chipfail/pmod-mux/README.md

# MUX PMOD Hardware
MUX PMOD Hardware

[Digikey Cart for 10 boards](https://www.digikey.com/short/pm0rpt)
