chipfail/pmod-mux/Rev A/Gerbers/read_me.txt

Cryptotronix LLC
Kirill V. Belyayev
kirill@cryptotronix.com
MUX PMOD PCB, Rev A
06/13/2019

Files included:
  muxpmod_2019-06-13.zip    A zip file of all PCB gerbers

PCB Fab Requirements:
  - 2-Layer PCB Stackup
  - 1oz Top and Bottom Copper Thickness
  - Finish: Lead Free HASL
  - Soldermask on top and bottom
  - Silkscreen on top and bottom
  - PCB Thickness: 0.062"
  - PCB Material: FR-04

Gerber File Naming Conventions
  copper_top.gbr                Top Copper
  solderpaste_top.gbr           Top Paste
  silkscreen_top.gbr            Top Silkscreen
  soldermask_top.gbr            Top Soldermask
  copper_bottom.gbr             Bottom Copper
  solderpaste_bottom.gbr        Bottom Paste
  silkscreen_bottom.gbr         Bottom Silkscreen
  soldermask_bottom.gbr         Bottom Soldermask
  profile.gbr                   PCB Outline
  drills.xln                    Drill File, Excellon 24 format
