chipfail/pmod-mux/Rev A/muxpmod-schematics.pdf

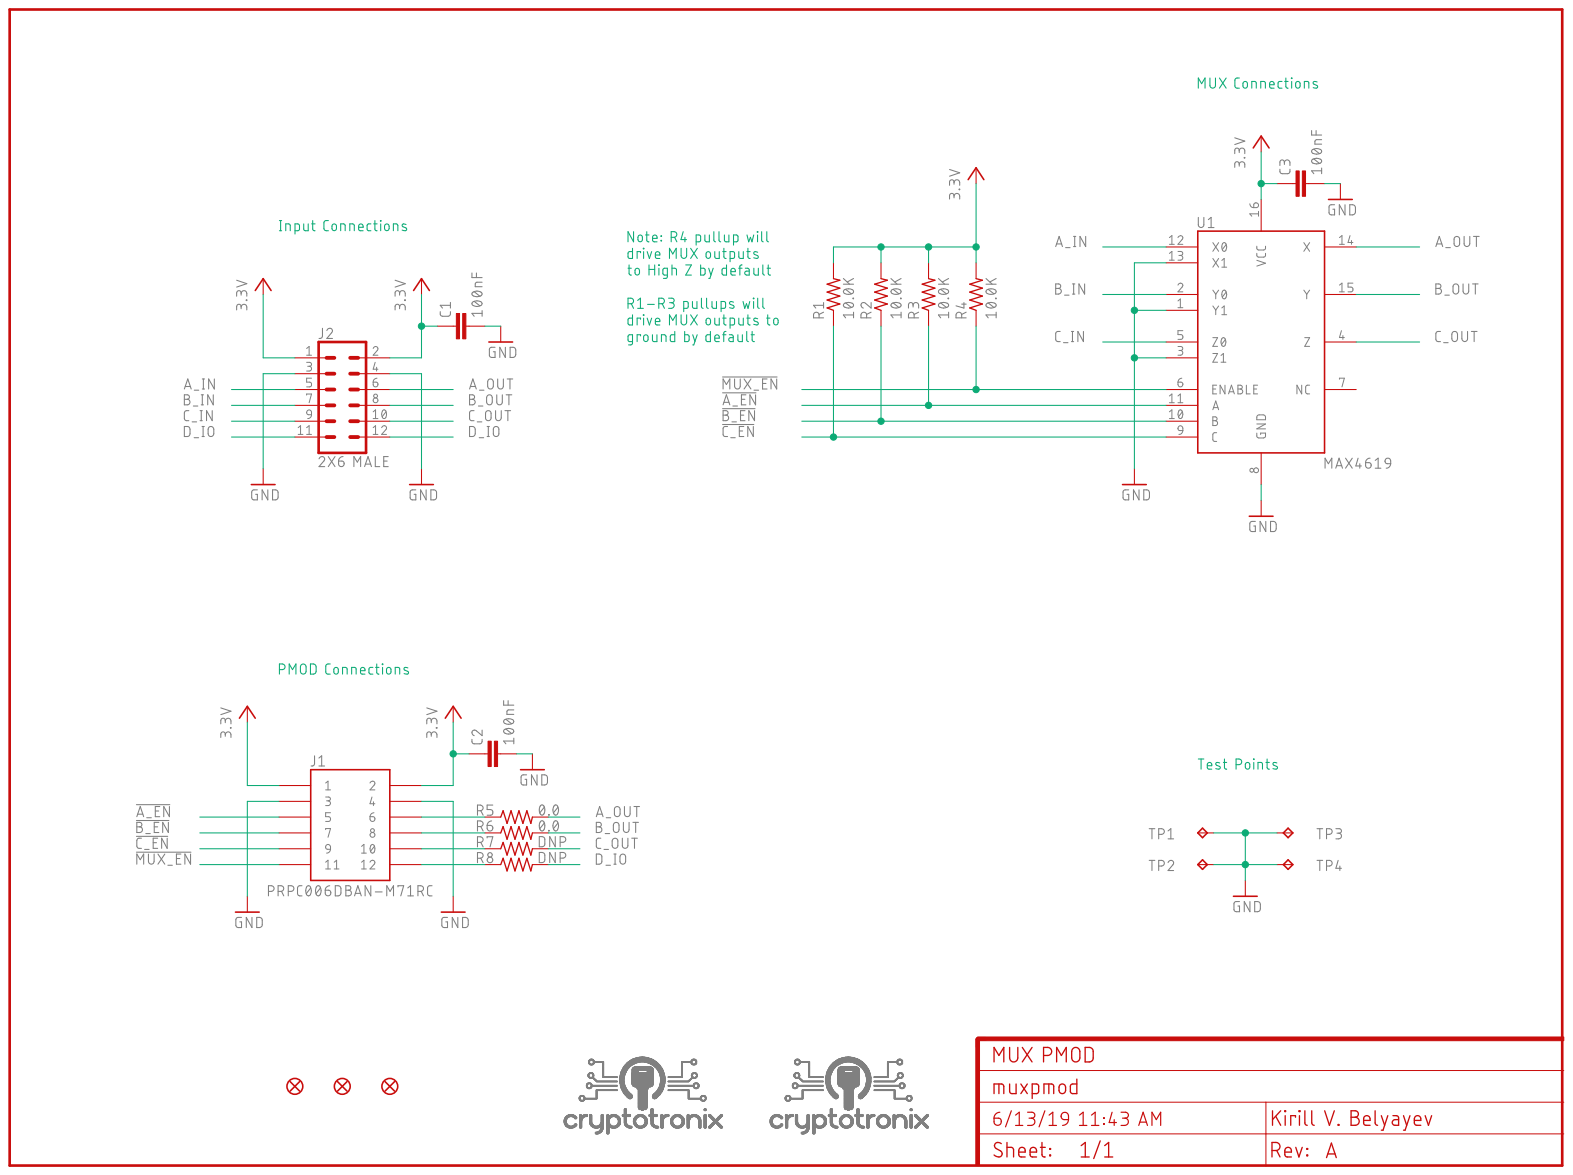
[picture p1: page 1]
