chipfail/pmod-mux/Rev A/muxpmod-bottom.pdf

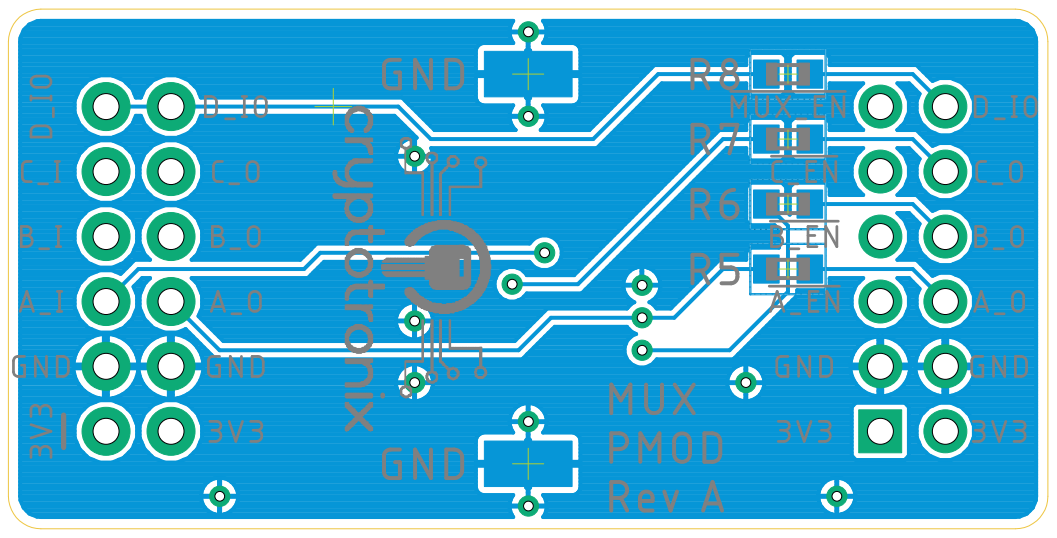
[picture p2: page 1]
