chipfail/pmod-mux/Rev A/muxpmod-dimensions.pdf

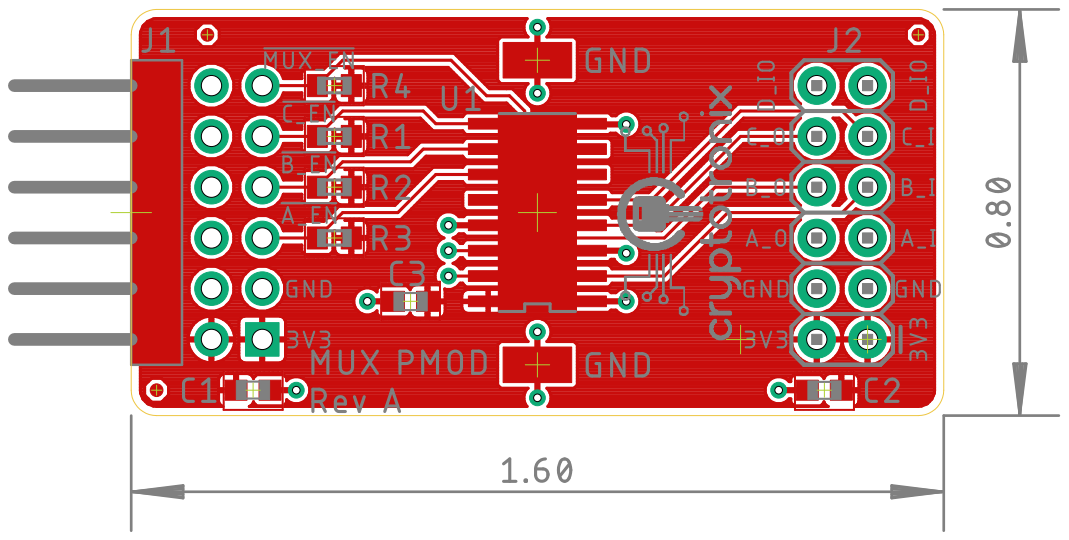
[picture p3: page 1]
