chipfail/pmod-mux/Rev A/muxpmod-top.pdf

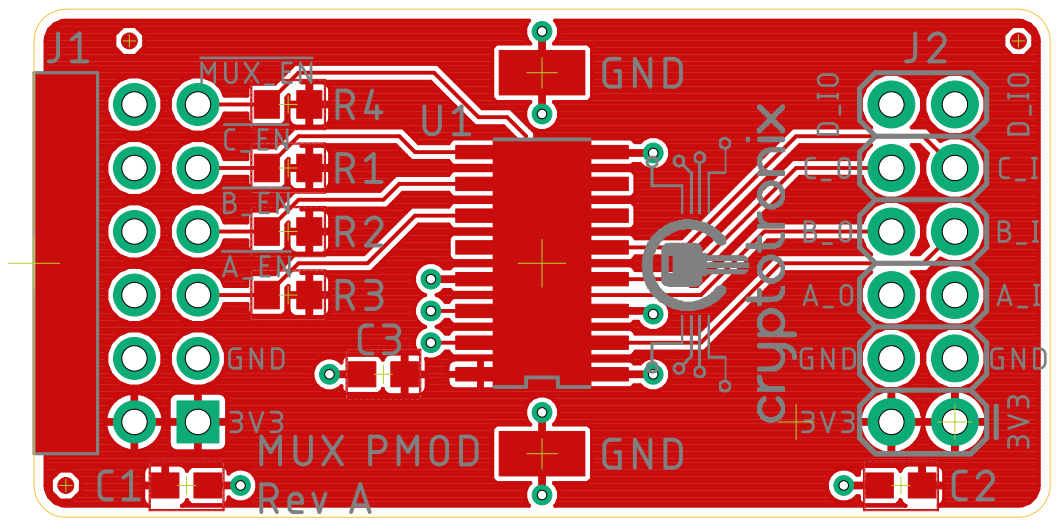
[picture p4: page 1]
