chipfail/pmod-mux/Rev A/muxpmod.brd

## EAGLE design Rev A/muxpmod.brd (2019-06-13)

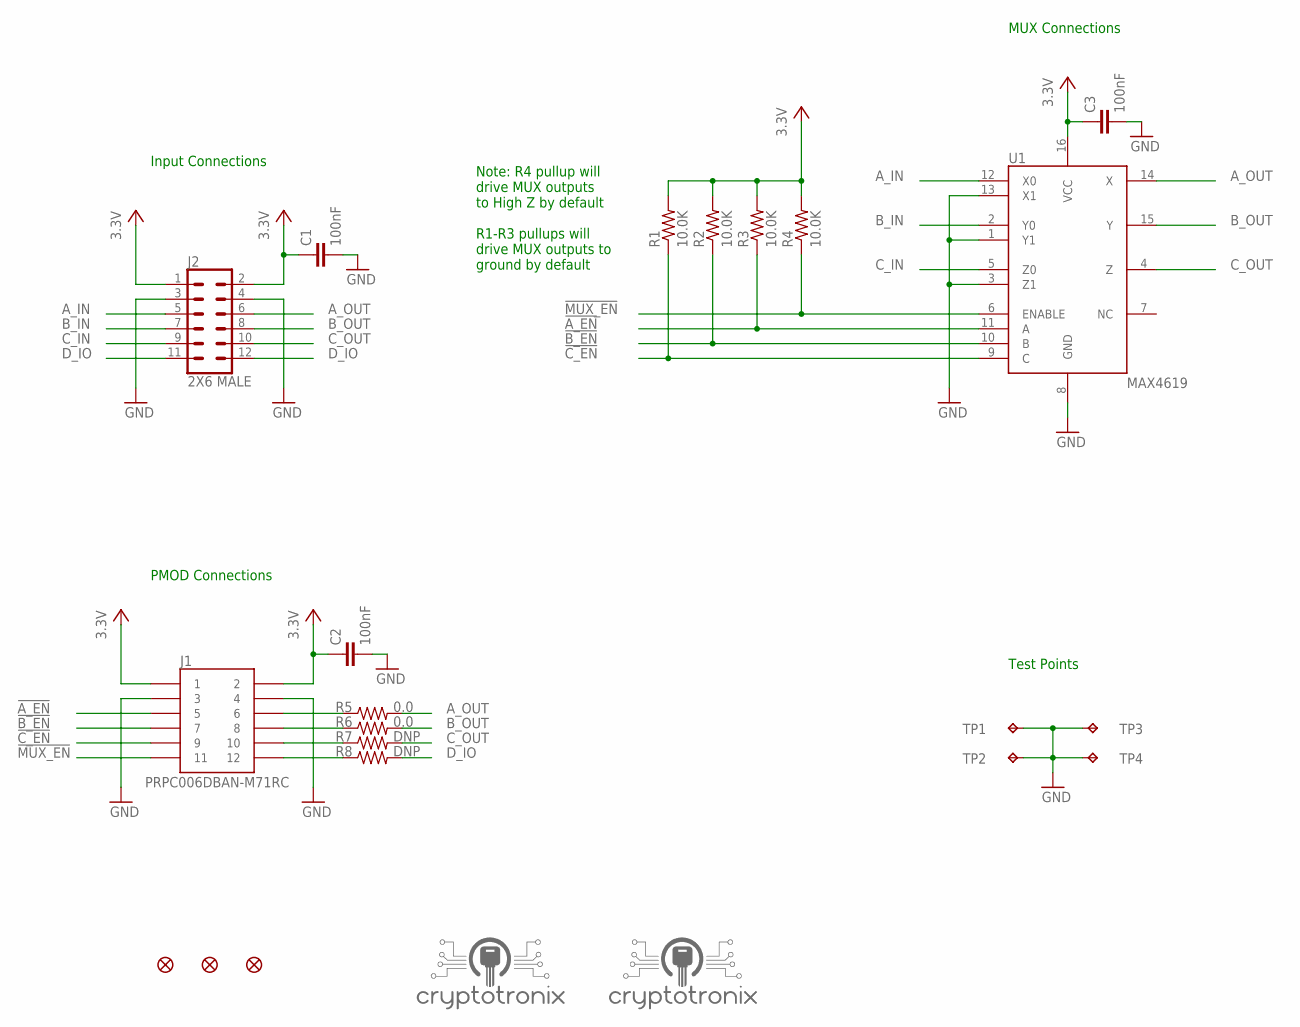
[picture p5: schematic muxpmod.sch]

Parts:
C1, C2, C3: 100nF; C0603
FD1, FD2, FD3: FIDUCIALUFIDUCIAL; MICRO-FIDUCIAL
J1: PRPC006DBAN-M71RC
J2: 2X6 MALE; 2X6
LOGO1, LOGO2: CRYPTOTRONIX_LOGO_S
R1, R2, R3, R4: 10.0K; R0603
R5, R6: 0.0; R0603
R7, R8: DNP; R0603
TP1, TP2, TP3, TP4: TEST-POINT-SM; 5015
U1: MAX4619; 16SOIC

Connections:
0V: C1.2, C2.2, C3.2, J1.3, J1.4, J2.3, J2.4, TP1.1, TP2.1, TP3.1, TP4.1, U1.1 (Y1), U1.3 (Z1), U1.8 (GND), U1.13 (X1)
3.3V: C1.1, C2.1, C3.1, J1.1, J1.2, J2.1, J2.2, R1.2, R2.2, R3.2, R4.2, U1.16 (VCC)
!A_EN: J1.5, R3.1, U1.11 (A)
!B_EN: J1.7, R2.1, U1.10 (B)
!C_EN: J1.9, R1.1, U1.9 (C)
!MUX_EN: J1.11, R4.1, U1.6 (ENABLE)
A_IN: J2.5, U1.12 (X0)
A_OUT: J2.6, R5.2, U1.14 (X)
B_IN: J2.7, U1.2 (Y0)
B_OUT: J2.8, R6.2, U1.15 (Y)
C_IN: J2.9, U1.5 (Z0)
C_OUT: J2.10, R7.2, U1.4 (Z)
D_IO: J2.11, J2.12, R8.2
unnamed: J1.6, R5.1
unnamed: J1.8, R6.1
unnamed: J1.10, R7.1
unnamed: J1.12, R8.1

Notes on the sheet:
PMOD Connections
MUX Connections
Note: R4 pullup will drive MUX outputs to High Z by default R1-R3 pullups will drive MUX outputs to ground by default
Test Points
Input Connections

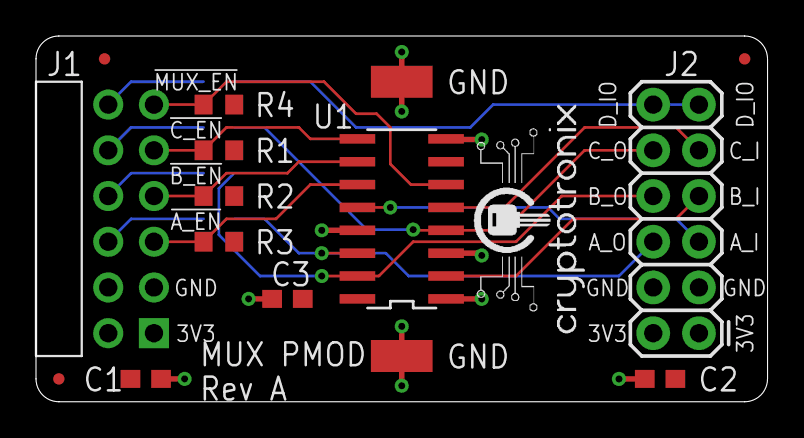
[picture p6: board muxpmod.brd from above]

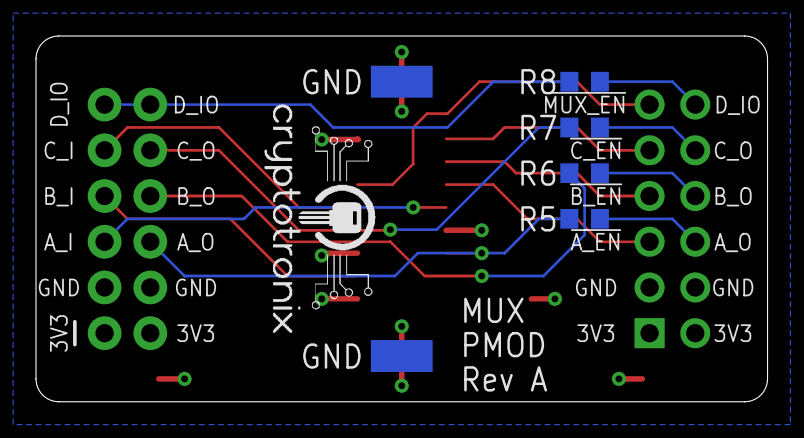
[picture p7: board muxpmod.brd from below]

Board: 2 copper layers, 40.6 x 20.3 mm, 23 parts (7 on the bottom side), 17 nets.
