chipfail/pmod-mux/(threads)

Thread 1 (2019-08-22):

Add a more helpful readme

jbdatko, 2019-08-22:
Josh (and I'm speaking about myself in the third person here) should add a helpful diagram and wiring guide and a basic how-to.

romanoLT, 2020-03-17:
that would be great indeed! Also, the Digi-Key link seems deprecated and just display one resistor reference. Any chance to acquire a built-in PCB for the pmod mux? thanks
